maccesch/custom-ruler-test/cad/caliper_static.FCStd

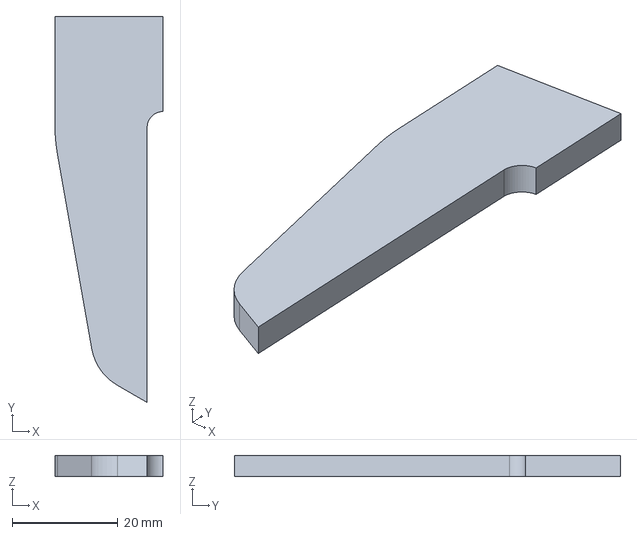
[picture p3: CAD file, 2026-10-28]
cad/caliper_static.FCStd
20.5 x 73.1 x 4.00 mm
