maccesch/custom-ruler-test/cad/caliper_static.orig.3mf

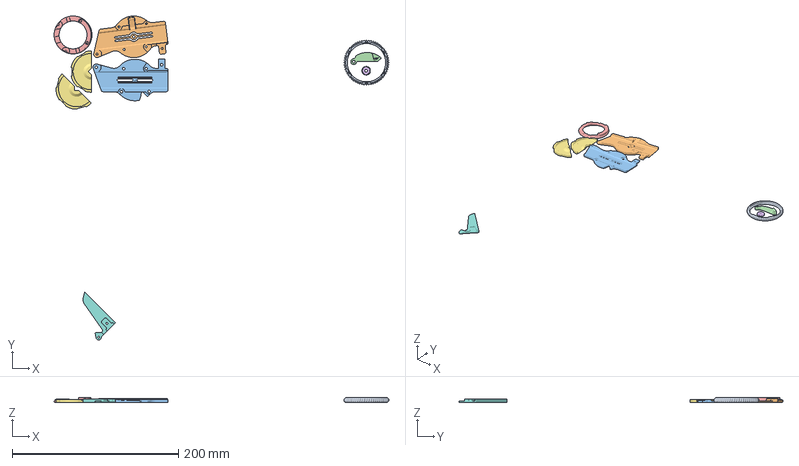
[picture p7: CAD file, 2026-10-28]
cad/caliper_static.orig.3mf
402.8 x 389.8 x 6.00 mm
DialRing
SliderTop
SliderBottom
ArrestLever
SliderTopConnectRing
ThumbPinion
FacePlate x 2
SliderBar
