maccesch/custom-ruler-test/public/cad/caliper_static.3mf

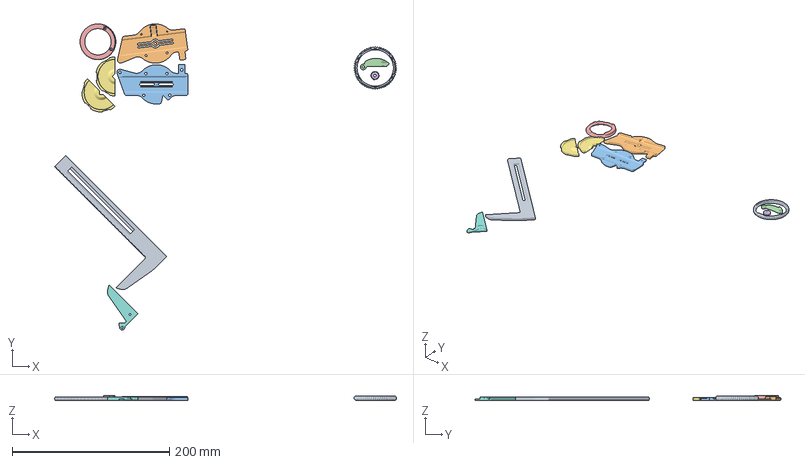
[picture p8: CAD file, 2026-10-28]
public/cad/caliper_static.3mf
435.4 x 389.8 x 6.00 mm
DialRing
SliderTop
SliderBottom
ArrestLever
SliderTopConnectRing
ThumbPinion
FacePlate x 2
SliderBar
Beam
Black bar
