maccesch/custom-ruler-test/(list of files, cad)

Other CAD files:
public/cad/top_bar.step
cad/caliper_static_with_beam.3mf
cad/top_bar.step
cad/caliper_static.3mf
